leonhiem/cs1800_fpga_cpu/hardware/de0nano_cpu_card/docs/front-panel-notes.md

Front panel notes

Standard 19 inch rack based, covering 2 slots

dimensions: width=40mm  height=128mm
