leonhiem/cs1800_fpga_cpu/hardware/de0nano_cpu_card/bom_smd_assembly.csv

LCSC Part# | MFR.Part# | Designator | Comment | Footprint | Qty | DNP
C14858 | CL10C101JB8NNNC | C1 | 100pF | Capacitor_SMD:C_0603_1608Metric | 1
C2991729 | 0603B104J250NT | C2,C3,C4,C5,C6,C7,C8,C9,C10,C11,C12,C13,C16,C17,C18,C19,C20,C21,C22,C23,C24 | 100nF | Capacitor_SMD:C_0603_1608Metric | 21
C49066 | CL32A107MQVNNNE | C14 | 100uF_LowESR | Capacitor_SMD:C_1210_3225Metric | 1
C39232 | CL32B106KAJNNNE | C15 | 10uF_LowESR | Capacitor_SMD:C_1210_3225Metric | 1
C169541 | 1N5817W | D1 | 1N5817 | Diode_SMD:D_SMA | 1
C5139509 | ABD03K1002FT | R1,R2,R3,R4,R5,R6,R7,R8,R9,R10,R11,R12,R13,R14,R15,R16,R17,R18,R19,R20,R21,R22,R23,R24 | 10k | Resistor_SMD:R_0603_1608Metric | 24
C5139509 | ABD03K1002FT | R_SW1,R_SW2,R_SW3,R_SW4,R_SW5,R_SW6 | 10k | Resistor_SMD:R_0603_1608Metric | 6
C53224189 | 1RC0603F1009 | R28,R29,R30,R31 | 10 | Resistor_SMD:R_0603_1608Metric | 4
C427298 | ERJP03F2200V | R_D1,R_D2,R_D3,R_D4 | 220 | Resistor_SMD:R_0603_1608Metric | 4
C27643 | SN74LVC8T245PWR | U1,U2,U3,U4,U5,U6,U8,U9 | SN74LVC8T245 | Package_SO:TSSOP-24_4.4x7.8mm_P0.65mm | 8
C193666 | MAX3232EIDR | U7 | MAX3232EIDR | Package_SO:SOIC-16_3.9x9.9mm_P1.27mm | 1
