leonhiem/cs1800_fpga_cpu/hardware/de0nano_cpu_card/bom.csv

Designator | Comment | Footprint | Qty | DNP
A1 | RaspberryPi_Pico_W | cs1800:RaspberryPi_Pico_W_SocketHeaders_2x1x20_P2.54mm | 1
C1 | 100pF | Capacitor_SMD:C_0603_1608Metric | 1
C2,C3,C4,C5,C6,C7,C8,C9,C10,C11,C12,C13,C21,C22,C23,C24 | 100nF | Capacitor_SMD:C_0603_1608Metric | 16
C14 | 100uF_LowESR | Capacitor_SMD:C_1210_3225Metric | 1
C15 | 10uF_LowESR | Capacitor_SMD:C_1210_3225Metric | 1
C16,C17,C18,C19,C20 | 0.1uF | Capacitor_SMD:C_0603_1608Metric | 5
D1 | 1N5817 | Diode_SMD:D_SMA | 1
D2 | LED_Green | LED_THT:LED_D3.0mm | 1
D3 | LED_Yellow | LED_THT:LED_D3.0mm | 1
D4,D5 | LED_Red | LED_THT:LED_D3.0mm | 2
J1 | DIN41617_31P | cs1800:DIN41617_31P_Male_Angled | 1
J2 | EXP_HEADER_2x11 | Connector_PinHeader_2.54mm:PinHeader_2x11_P2.54mm_Vertical | 1
J3 | GPIO_0_JP1 | Connector_IDC:IDC-Header_2x20_P2.54mm_Vertical | 1
J4 | GPIO_1_JP2 | Connector_IDC:IDC-Header_2x20_P2.54mm_Vertical | 1
J5 | DB9_RS232 | Connector_Dsub:DSUB-9_Pins_Horizontal_P2.77x2.54mm_EdgePinOffset9.40mm | 1
P1 | DE0Nano_5V_feed | Connector_PinHeader_2.54mm:PinHeader_1x02_P2.54mm_Vertical | 1
R1,R2,R3,R4,R5,R6,R7,R8,R9,R10,R11,R12,R13,R14,R15,R16,R17,R18,R19,R20,R21,R22,R23,R24,R_SW1,R_SW2,R_SW3,R_SW4,R_SW5,R_SW6 | 10k | Resistor_SMD:R_0603_1608Metric | 30
R28,R29,R30,R31 | 10 | Resistor_SMD:R_0603_1608Metric | 4
R_D1,R_D2,R_D3,R_D4 | 220 | Resistor_SMD:R_0603_1608Metric | 4
SW1 | Rocker_run/halt | Connector_PinHeader_2.54mm:PinHeader_1x02_P2.54mm_Vertical | 1
SW2 | Rocker_dog_off | Connector_PinHeader_2.54mm:PinHeader_1x02_P2.54mm_Vertical | 1
SW3 | Rocker_LC_off | Connector_PinHeader_2.54mm:PinHeader_1x02_P2.54mm_Vertical | 1
SW4 | Button_step | Connector_PinHeader_2.54mm:PinHeader_1x02_P2.54mm_Vertical | 1
SW5 | Button_reset | Connector_PinHeader_2.54mm:PinHeader_1x02_P2.54mm_Vertical | 1
SW6 | Button_qef4 | Connector_PinHeader_2.54mm:PinHeader_1x02_P2.54mm_Vertical | 1
U1,U2,U3,U4,U5,U6,U8,U9 | SN74LVC8T245 | Package_SO:TSSOP-24_4.4x7.8mm_P0.65mm | 8
U7 | MAX3232EIDR | Package_SO:SOIC-16_3.9x9.9mm_P1.27mm | 1
