leonhiem/cs1800_fpga_cpu/hardware/de0nano_cpu_card/de0nano_cpu_card.kicad_pcb

## KiCad design hardware/de0nano_cpu_card/de0nano_cpu_card.kicad_pcb (2026-10-16)

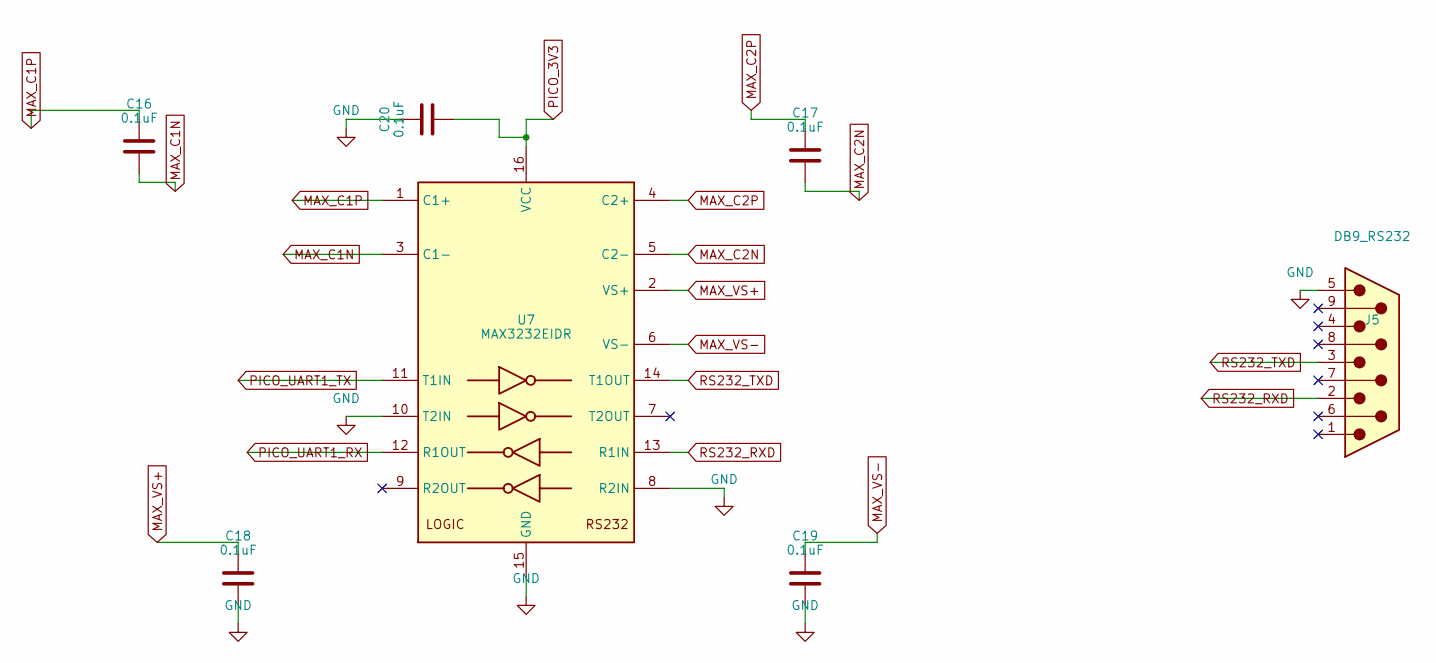
[picture p1: schematic rs232.kicad_sch, RS232 Transceiver (MAX3232) + DB9]

Parts:
C16, C17, C18, C19, C20: 0.1uF; C_0603_1608Metric
J5: DB9_RS232; DSUB-9_Pins_Horizontal_P2.77x2.54mm_EdgePinOffset9.40mm
U7: MAX3232EIDR; SOIC-16_3.9x9.9mm_P1.27mm

Connections:
GND: C18.2, C19.2, C20.1, J5.5, U7.8 (R2IN), U7.10 (T2IN), U7.15 (GND); also elsewhere on the board
MAX_C1N: C16.2, U7.3 (C1-)
MAX_C1P: C16.1, U7.1 (C1+)
MAX_C2N: C17.2, U7.5 (C2-)
MAX_C2P: C17.1, U7.4 (C2+)
MAX_VS+: C18.1, U7.2 (VS+)
MAX_VS-: C19.1, U7.6 (VS-)
PICO_3V3: C20.2, U7.16 (VCC); also elsewhere on the board
PICO_UART1_RX: U7.12 (R1OUT); also elsewhere on the board
PICO_UART1_TX: U7.11 (T1IN); also elsewhere on the board
RS232_RXD: J5.2, U7.13 (R1IN)
RS232_TXD: J5.3, U7.14 (T1OUT)

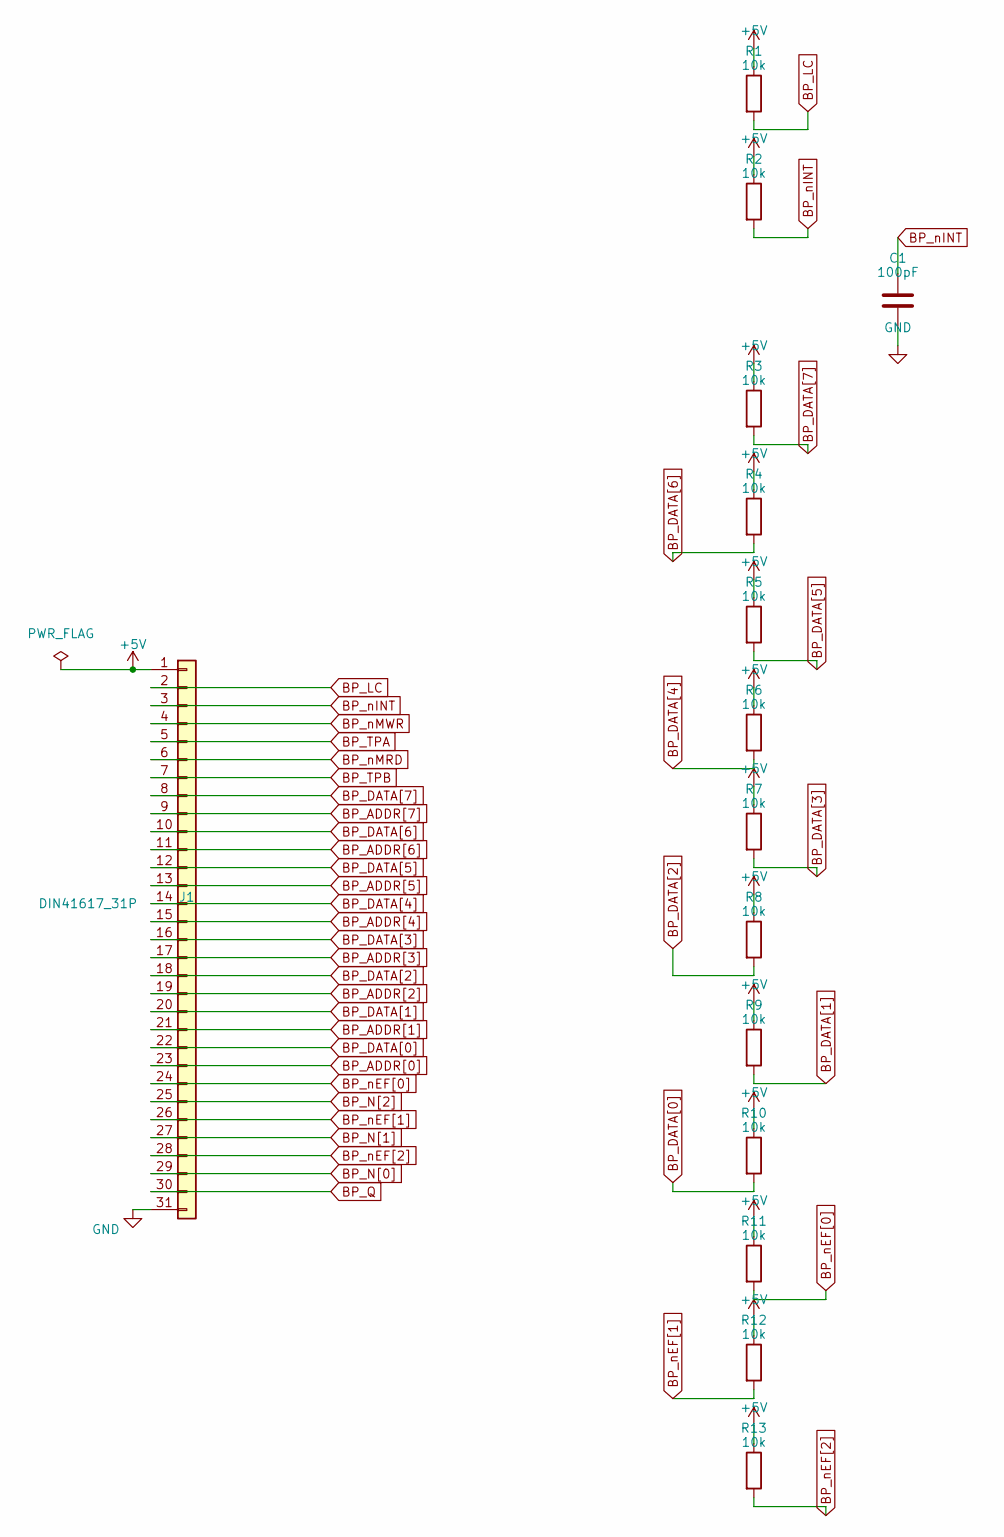
[picture p2: schematic backplane_connector.kicad_sch, Backplane Connector (DIN41617, 31p male)]

Parts:
C1: 100pF; C_0603_1608Metric
J1: DIN41617_31P; DIN41617_31P_Male_Angled
R1, R2, R3, R4, R5, R6, R7, R8, R9, R10, R11, R12, R13: 10k; R_0603_1608Metric

Connections:
+5V: J1.1, R1.1, R2.1, R3.1, R4.1, R5.1, R6.1, R7.1, R8.1, R9.1, R10.1, R11.1, R12.1, R13.1; also elsewhere on the board
BP_ADDR[0]: J1.23; also elsewhere on the board
BP_ADDR[1]: J1.21; also elsewhere on the board
BP_ADDR[2]: J1.19; also elsewhere on the board
BP_ADDR[3]: J1.17; also elsewhere on the board
BP_ADDR[4]: J1.15; also elsewhere on the board
BP_ADDR[5]: J1.13; also elsewhere on the board
BP_ADDR[6]: J1.11; also elsewhere on the board
BP_ADDR[7]: J1.9; also elsewhere on the board
BP_DATA[0]: J1.22, R10.2; also elsewhere on the board
BP_DATA[1]: J1.20, R9.2; also elsewhere on the board
BP_DATA[2]: J1.18, R8.2; also elsewhere on the board
BP_DATA[3]: J1.16, R7.2; also elsewhere on the board
BP_DATA[4]: J1.14, R6.2; also elsewhere on the board
BP_DATA[5]: J1.12, R5.2; also elsewhere on the board
BP_DATA[6]: J1.10, R4.2; also elsewhere on the board
BP_DATA[7]: J1.8, R3.2; also elsewhere on the board
BP_LC: J1.2, R1.2; also elsewhere on the board
BP_N[0]: J1.29; also elsewhere on the board
BP_N[1]: J1.27; also elsewhere on the board
BP_N[2]: J1.25; also elsewhere on the board
BP_Q: J1.30; also elsewhere on the board
BP_TPA: J1.5; also elsewhere on the board
BP_TPB: J1.7; also elsewhere on the board
BP_nEF[0]: J1.24, R11.2; also elsewhere on the board
BP_nEF[1]: J1.26, R12.2; also elsewhere on the board
BP_nEF[2]: J1.28, R13.2; also elsewhere on the board
BP_nINT: C1.1, J1.3, R2.2; also elsewhere on the board
BP_nMRD: J1.6; also elsewhere on the board
BP_nMWR: J1.4; also elsewhere on the board
GND: C1.2, J1.31; also elsewhere on the board

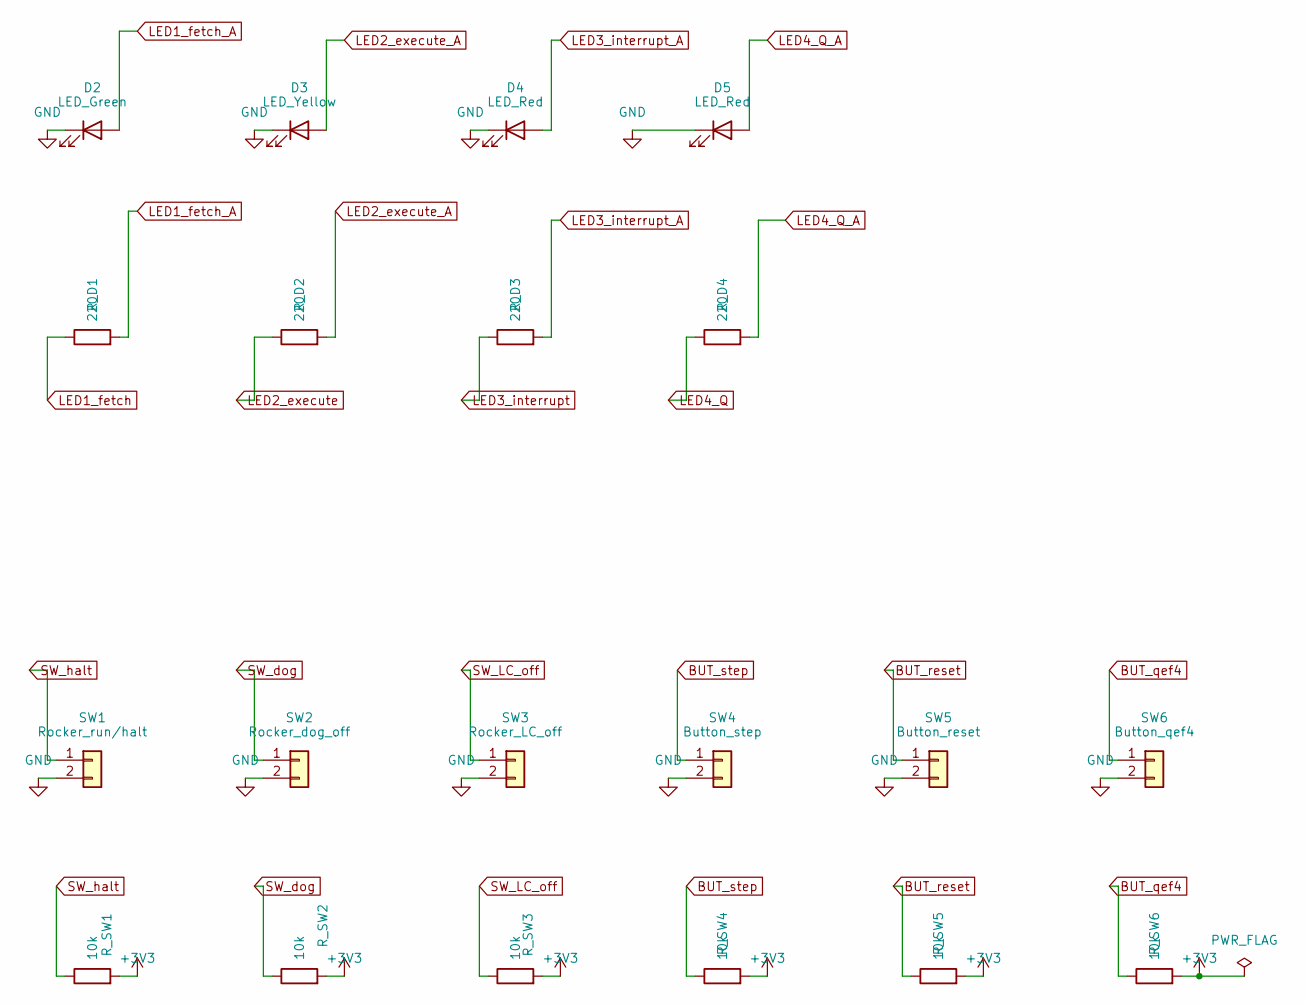
[picture p3: schematic frontpanel_io.kicad_sch, Front Panel I/O]

Parts:
D2: LED_Green; LED_D3.0mm
D3: LED_Yellow; LED_D3.0mm
D4, D5: LED_Red; LED_D3.0mm
R_D1, R_D2, R_D3, R_D4: 220; R_0603_1608Metric
R_SW1, R_SW2, R_SW3, R_SW4, R_SW5, R_SW6: 10k; R_0603_1608Metric
SW1: Rocker_run/halt; PinHeader_1x02_P2.54mm_Vertical
SW2: Rocker_dog_off; PinHeader_1x02_P2.54mm_Vertical
SW3: Rocker_LC_off; PinHeader_1x02_P2.54mm_Vertical
SW4: Button_step; PinHeader_1x02_P2.54mm_Vertical
SW5: Button_reset; PinHeader_1x02_P2.54mm_Vertical
SW6: Button_qef4; PinHeader_1x02_P2.54mm_Vertical

Connections:
+3V3: R_SW1.2, R_SW2.2, R_SW3.2, R_SW4.2, R_SW5.2, R_SW6.2; also elsewhere on the board
BUT_qef4: R_SW6.1, SW6.1; also elsewhere on the board
BUT_reset: R_SW5.1, SW5.1; also elsewhere on the board
BUT_step: R_SW4.1, SW4.1; also elsewhere on the board
GND: D2.1 (K), D3.1 (K), D4.1 (K), D5.1 (K), SW1.2, SW2.2, SW3.2, SW4.2, SW5.2, SW6.2; also elsewhere on the board
LED1_fetch: R_D1.1; also elsewhere on the board
LED1_fetch_A: D2.2 (A), R_D1.2
LED2_execute: R_D2.1; also elsewhere on the board
LED2_execute_A: D3.2 (A), R_D2.2
LED3_interrupt: R_D3.1; also elsewhere on the board
LED3_interrupt_A: D4.2 (A), R_D3.2
LED4_Q: R_D4.1; also elsewhere on the board
LED4_Q_A: D5.2 (A), R_D4.2
SW_LC_off: R_SW3.1, SW3.1; also elsewhere on the board
SW_dog: R_SW2.1, SW2.1; also elsewhere on the board
SW_halt: R_SW1.1, SW1.1; also elsewhere on the board

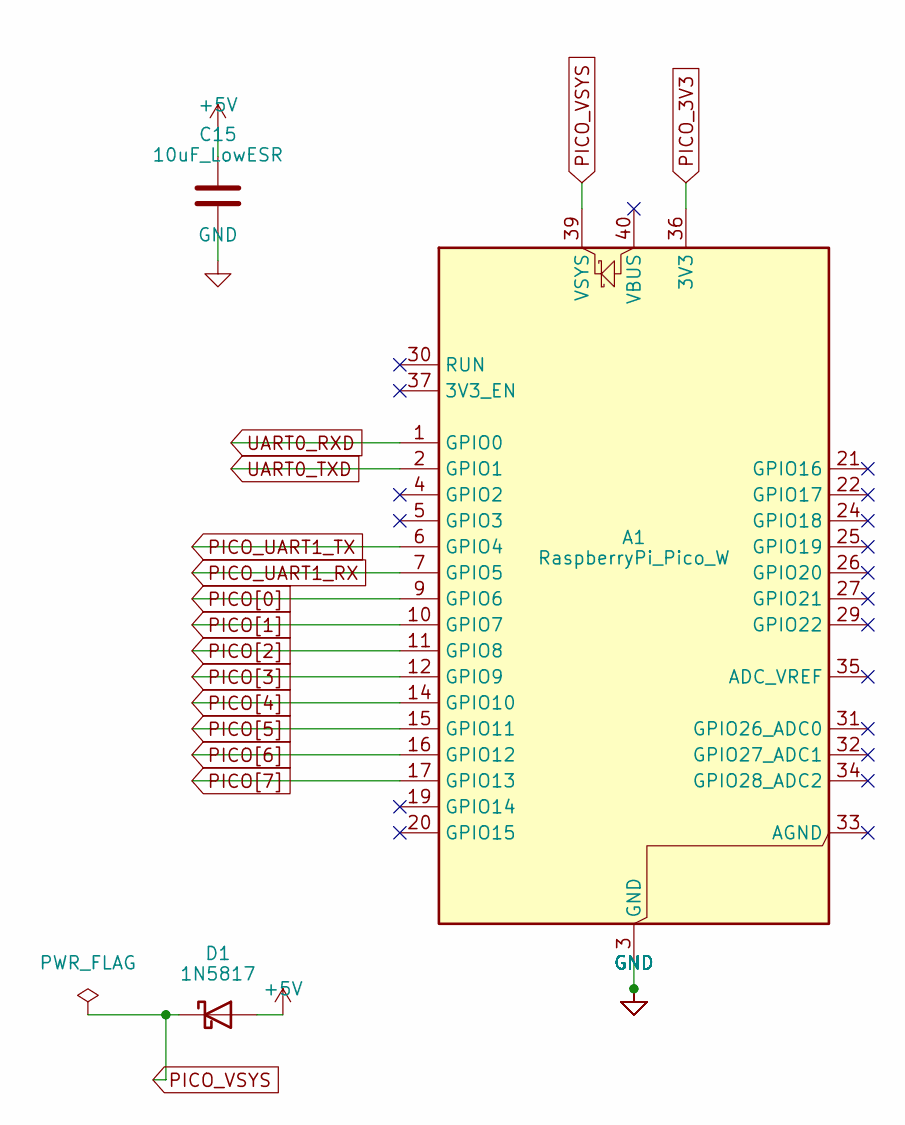
[picture p4: schematic pico_w_bridge.kicad_sch, UART Bridge (Raspberry Pi Pico-W)]

Parts:
A1: RaspberryPi_Pico_W; RaspberryPi_Pico_W_SocketHeaders_2x1x20_P2.54mm
C15: 10uF_LowESR; C_1210_3225Metric
D1: 1N5817; D_SMA

Connections:
+5V: C15.1, D1.2 (A); also elsewhere on the board
GND: A1.3 (GND), A1.8 (GND), A1.13 (GND), A1.18 (GND), A1.23 (GND), A1.28 (GND), A1.38 (GND), C15.2; also elsewhere on the board
PICO[0]: A1.9 (GPIO6); also elsewhere on the board
PICO[1]: A1.10 (GPIO7); also elsewhere on the board
PICO[2]: A1.11 (GPIO8); also elsewhere on the board
PICO[3]: A1.12 (GPIO9); also elsewhere on the board
PICO[4]: A1.14 (GPIO10); also elsewhere on the board
PICO[5]: A1.15 (GPIO11); also elsewhere on the board
PICO[6]: A1.16 (GPIO12); also elsewhere on the board
PICO[7]: A1.17 (GPIO13); also elsewhere on the board
PICO_3V3: A1.36 (3V3); also elsewhere on the board
PICO_UART1_RX: A1.7 (GPIO5); also elsewhere on the board
PICO_UART1_TX: A1.6 (GPIO4); also elsewhere on the board
PICO_VSYS: A1.39 (VSYS), D1.1 (K)
UART0_RXD: A1.1 (GPIO0); also elsewhere on the board
UART0_TXD: A1.2 (GPIO1); also elsewhere on the board

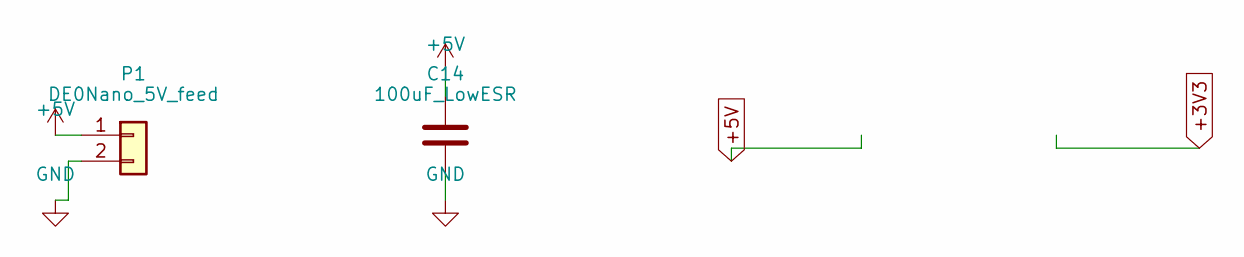
[picture p5: schematic power.kicad_sch, Power (5V in, DE0-Nano feed, rails)]

Parts:
C14: 100uF_LowESR; C_1210_3225Metric
P1: DE0Nano_5V_feed; PinHeader_1x02_P2.54mm_Vertical

Connections:
+5V: C14.1, P1.1; also elsewhere on the board
GND: C14.2, P1.2; also elsewhere on the board

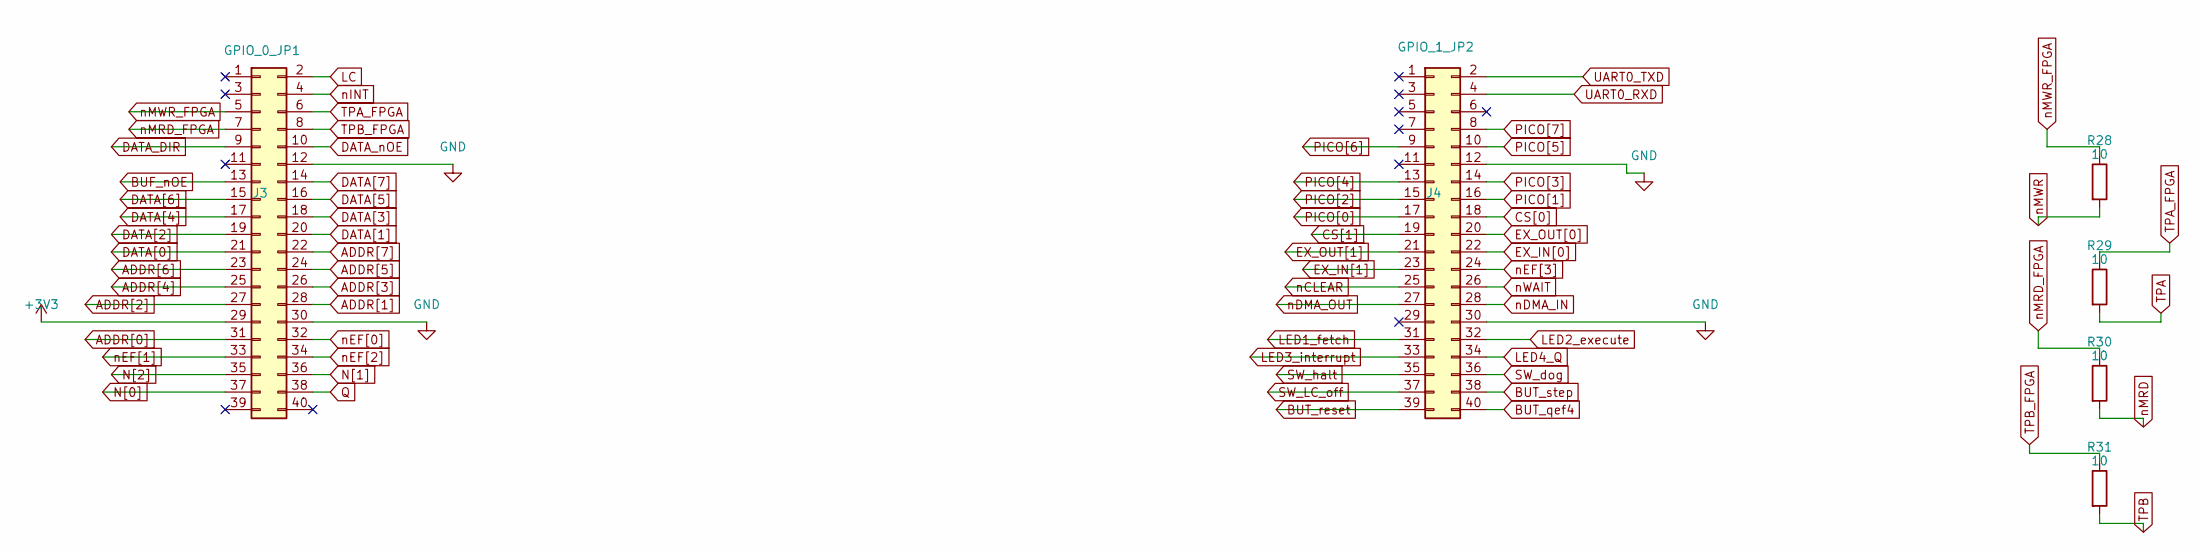
[picture p6: schematic fpga_header.kicad_sch, DE0-Nano GPIO Header / Ribbon I-F]

Parts:
J3: GPIO_0_JP1; IDC-Header_2x20_P2.54mm_Vertical
J4: GPIO_1_JP2; IDC-Header_2x20_P2.54mm_Vertical
R28, R29, R30, R31: 10; R_0603_1608Metric

Connections:
+3V3: J3.29; also elsewhere on the board
ADDR[0]: J3.31; also elsewhere on the board
ADDR[1]: J3.28; also elsewhere on the board
ADDR[2]: J3.27; also elsewhere on the board
ADDR[3]: J3.26; also elsewhere on the board
ADDR[4]: J3.25; also elsewhere on the board
ADDR[5]: J3.24; also elsewhere on the board
ADDR[6]: J3.23; also elsewhere on the board
ADDR[7]: J3.22; also elsewhere on the board
BUF_nOE: J3.13; also elsewhere on the board
BUT_qef4: J4.40; also elsewhere on the board
BUT_reset: J4.39; also elsewhere on the board
BUT_step: J4.38; also elsewhere on the board
CS[0]: J4.18; also elsewhere on the board
CS[1]: J4.19; also elsewhere on the board
DATA[0]: J3.21; also elsewhere on the board
DATA[1]: J3.20; also elsewhere on the board
DATA[2]: J3.19; also elsewhere on the board
DATA[3]: J3.18; also elsewhere on the board
DATA[4]: J3.17; also elsewhere on the board
DATA[5]: J3.16; also elsewhere on the board
DATA[6]: J3.15; also elsewhere on the board
DATA[7]: J3.14; also elsewhere on the board
DATA_DIR: J3.9; also elsewhere on the board
DATA_nOE: J3.10; also elsewhere on the board
EX_IN[0]: J4.22; also elsewhere on the board
EX_IN[1]: J4.23; also elsewhere on the board
EX_OUT[0]: J4.20; also elsewhere on the board
EX_OUT[1]: J4.21; also elsewhere on the board
GND: J3.12, J3.30, J4.12, J4.30; also elsewhere on the board
LC: J3.2; also elsewhere on the board
LED1_fetch: J4.31; also elsewhere on the board
LED2_execute: J4.32; also elsewhere on the board
LED3_interrupt: J4.33; also elsewhere on the board
LED4_Q: J4.34; also elsewhere on the board
N[0]: J3.37; also elsewhere on the board
N[1]: J3.36; also elsewhere on the board
N[2]: J3.35; also elsewhere on the board
PICO[0]: J4.17; also elsewhere on the board
PICO[1]: J4.16; also elsewhere on the board
PICO[2]: J4.15; also elsewhere on the board
PICO[3]: J4.14; also elsewhere on the board
PICO[4]: J4.13; also elsewhere on the board
PICO[5]: J4.10; also elsewhere on the board
PICO[6]: J4.9; also elsewhere on the board
PICO[7]: J4.8; also elsewhere on the board
Q: J3.38; also elsewhere on the board
SW_LC_off: J4.37; also elsewhere on the board
SW_dog: J4.36; also elsewhere on the board
SW_halt: J4.35; also elsewhere on the board
TPA: R29.2; also elsewhere on the board
TPA_FPGA: J3.6, R29.1
TPB: R31.2; also elsewhere on the board
TPB_FPGA: J3.8, R31.1
UART0_RXD: J4.4; also elsewhere on the board
UART0_TXD: J4.2; also elsewhere on the board
nCLEAR: J4.25; also elsewhere on the board
nDMA_IN: J4.28; also elsewhere on the board
nDMA_OUT: J4.27; also elsewhere on the board
nEF[0]: J3.32; also elsewhere on the board
nEF[1]: J3.33; also elsewhere on the board
nEF[2]: J3.34; also elsewhere on the board
nEF[3]: J4.24; also elsewhere on the board
nINT: J3.4; also elsewhere on the board
nMRD: R30.2; also elsewhere on the board
nMRD_FPGA: J3.7, R30.1
nMWR: R28.2; also elsewhere on the board
nMWR_FPGA: J3.5, R28.1
nWAIT: J4.26; also elsewhere on the board

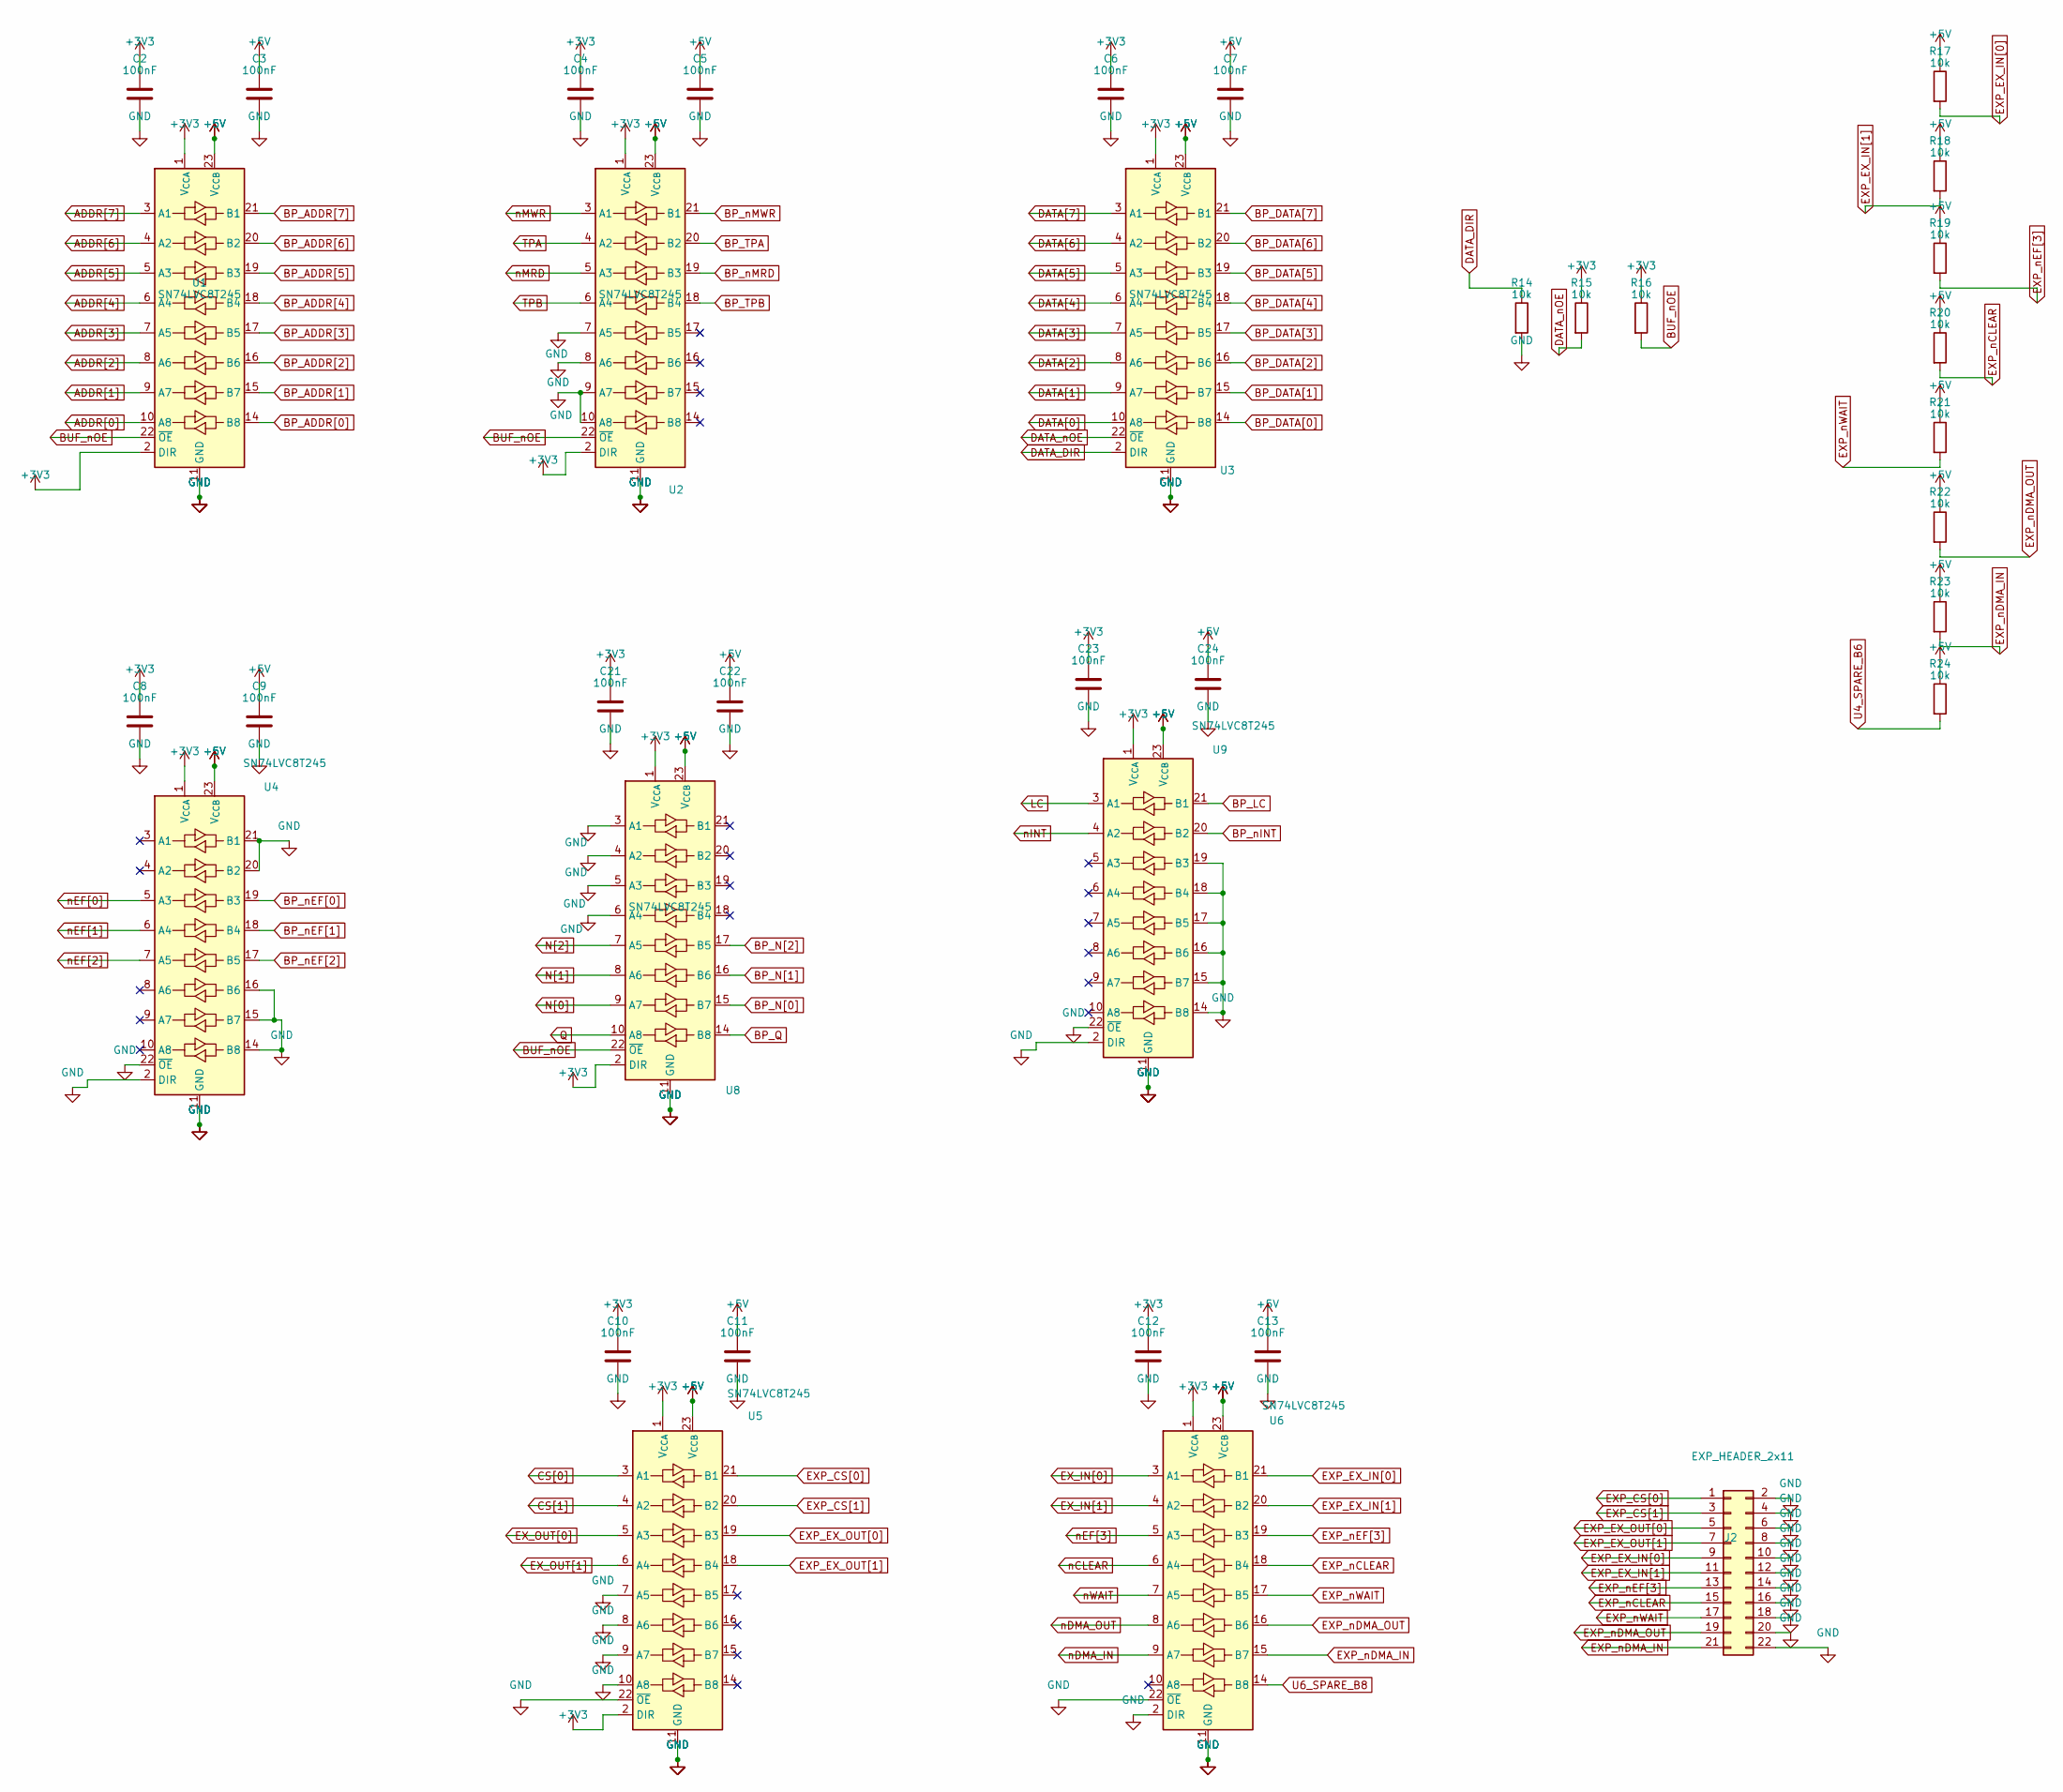
[picture p7: schematic level_shifters.kicad_sch, Level Shifters (6x SN74LVC8T245)]

Parts:
C2, C3, C4, C5, C6, C7, C8, C9, C10, C11, C12, C13, C21, C22, C23, C24: 100nF; C_0603_1608Metric
J2: EXP_HEADER_2x11; PinHeader_2x11_P2.54mm_Vertical
R14, R15, R16, R17, R18, R19, R20, R21, R22, R23, R24: 10k; R_0603_1608Metric
U1, U2, U3, U4, U5, U6, U8, U9: SN74LVC8T245; TSSOP-24_4.4x7.8mm_P0.65mm

Connections:
+3V3: C2.1, C4.1, C6.1, C8.1, C10.1, C12.1, C21.1, C23.1, R15.1, R16.1, U1.1 (V_{CCA}), U1.2 (DIR), U2.1 (V_{CCA}), U2.2 (DIR), U3.1 (V_{CCA}), U4.1 (V_{CCA}), U5.1 (V_{CCA}), U5.2 (DIR), U6.1 (V_{CCA}), U8.1 (V_{CCA}), U8.2 (DIR), U9.1 (V_{CCA}); also elsewhere on the board
+5V: C3.1, C5.1, C7.1, C9.1, C11.1, C13.1, C22.1, C24.1, R17.1, R18.1, R19.1, R20.1, R21.1, R22.1, R23.1, R24.1, U1.23 (V_{CCB}), U1.24 (V_{CCB}), U2.23 (V_{CCB}), U2.24 (V_{CCB}), U3.23 (V_{CCB}), U3.24 (V_{CCB}), U4.23 (V_{CCB}), U4.24 (V_{CCB}), U5.23 (V_{CCB}), U5.24 (V_{CCB}), U6.23 (V_{CCB}), U6.24 (V_{CCB}), U8.23 (V_{CCB}), U8.24 (V_{CCB}), U9.23 (V_{CCB}), U9.24 (V_{CCB}); also elsewhere on the board
ADDR[0]: U1.10 (A8); also elsewhere on the board
ADDR[1]: U1.9 (A7); also elsewhere on the board
ADDR[2]: U1.8 (A6); also elsewhere on the board
ADDR[3]: U1.7 (A5); also elsewhere on the board
ADDR[4]: U1.6 (A4); also elsewhere on the board
ADDR[5]: U1.5 (A3); also elsewhere on the board
ADDR[6]: U1.4 (A2); also elsewhere on the board
ADDR[7]: U1.3 (A1); also elsewhere on the board
BP_ADDR[0]: U1.14 (B8); also elsewhere on the board
BP_ADDR[1]: U1.15 (B7); also elsewhere on the board
BP_ADDR[2]: U1.16 (B6); also elsewhere on the board
BP_ADDR[3]: U1.17 (B5); also elsewhere on the board
BP_ADDR[4]: U1.18 (B4); also elsewhere on the board
BP_ADDR[5]: U1.19 (B3); also elsewhere on the board
BP_ADDR[6]: U1.20 (B2); also elsewhere on the board
BP_ADDR[7]: U1.21 (B1); also elsewhere on the board
BP_DATA[0]: U3.14 (B8); also elsewhere on the board
BP_DATA[1]: U3.15 (B7); also elsewhere on the board
BP_DATA[2]: U3.16 (B6); also elsewhere on the board
BP_DATA[3]: U3.17 (B5); also elsewhere on the board
BP_DATA[4]: U3.18 (B4); also elsewhere on the board
BP_DATA[5]: U3.19 (B3); also elsewhere on the board
BP_DATA[6]: U3.20 (B2); also elsewhere on the board
BP_DATA[7]: U3.21 (B1); also elsewhere on the board
BP_LC: U9.21 (B1); also elsewhere on the board
BP_N[0]: U8.15 (B7); also elsewhere on the board
BP_N[1]: U8.16 (B6); also elsewhere on the board
BP_N[2]: U8.17 (B5); also elsewhere on the board
BP_Q: U8.14 (B8); also elsewhere on the board
BP_TPA: U2.20 (B2); also elsewhere on the board
BP_TPB: U2.18 (B4); also elsewhere on the board
BP_nEF[0]: U4.19 (B3); also elsewhere on the board
BP_nEF[1]: U4.18 (B4); also elsewhere on the board
BP_nEF[2]: U4.17 (B5); also elsewhere on the board
BP_nINT: U9.20 (B2); also elsewhere on the board
BP_nMRD: U2.19 (B3); also elsewhere on the board
BP_nMWR: U2.21 (B1); also elsewhere on the board
BUF_nOE: R16.2, U1.22 (~OE), U2.22 (~OE), U8.22 (~OE); also elsewhere on the board
CS[0]: U5.3 (A1); also elsewhere on the board
CS[1]: U5.4 (A2); also elsewhere on the board
DATA[0]: U3.10 (A8); also elsewhere on the board
DATA[1]: U3.9 (A7); also elsewhere on the board
DATA[2]: U3.8 (A6); also elsewhere on the board
DATA[3]: U3.7 (A5); also elsewhere on the board
DATA[4]: U3.6 (A4); also elsewhere on the board
DATA[5]: U3.5 (A3); also elsewhere on the board
DATA[6]: U3.4 (A2); also elsewhere on the board
DATA[7]: U3.3 (A1); also elsewhere on the board
DATA_DIR: R14.1, U3.2 (DIR); also elsewhere on the board
DATA_nOE: R15.2, U3.22 (~OE); also elsewhere on the board
EXP_CS[0]: J2.1, U5.21 (B1)
EXP_CS[1]: J2.3, U5.20 (B2)
EXP_EX_IN[0]: J2.9, R17.2, U6.21 (B1)
EXP_EX_IN[1]: J2.11, R18.2, U6.20 (B2)
EXP_EX_OUT[0]: J2.5, U5.19 (B3)
EXP_EX_OUT[1]: J2.7, U5.18 (B4)
EXP_nCLEAR: J2.15, R20.2, U6.18 (B4)
EXP_nDMA_IN: J2.21, R23.2, U6.15 (B7)
EXP_nDMA_OUT: J2.19, R22.2, U6.16 (B6)
EXP_nEF[3]: J2.13, R19.2, U6.19 (B3)
EXP_nWAIT: J2.17, R21.2, U6.17 (B5)
EX_IN[0]: U6.3 (A1); also elsewhere on the board
EX_IN[1]: U6.4 (A2); also elsewhere on the board
EX_OUT[0]: U5.5 (A3); also elsewhere on the board
EX_OUT[1]: U5.6 (A4); also elsewhere on the board
GND: C2.2, C3.2, C4.2, C5.2, C6.2, C7.2, C8.2, C9.2, C10.2, C11.2, C12.2, C13.2, C21.2, C22.2, C23.2, C24.2, J2.2, J2.4, J2.6, J2.8, J2.10, J2.12, J2.14, J2.16, J2.18, J2.20, J2.22, R14.2, U1.11 (GND), U1.12 (GND), U1.13 (GND), U2.7 (A5), U2.8 (A6), U2.9 (A7), U2.10 (A8), U2.11 (GND), U2.12 (GND), U2.13 (GND), U3.11 (GND), U3.12 (GND), U3.13 (GND), U4.2 (DIR), U4.11 (GND), U4.12 (GND), U4.13 (GND), U4.14 (B8), U4.15 (B7), U4.16 (B6), U4.20 (B2), U4.21 (B1), U4.22 (~OE), U5.7 (A5), U5.8 (A6), U5.9 (A7), U5.10 (A8), U5.11 (GND), U5.12 (GND), U5.13 (GND), U5.22 (~OE), U6.2 (DIR), U6.11 (GND), U6.12 (GND), U6.13 (GND), U6.22 (~OE), U8.3 (A1), U8.4 (A2), U8.5 (A3), U8.6 (A4), U8.11 (GND), U8.12 (GND), U8.13 (GND), U9.2 (DIR), U9.11 (GND), U9.12 (GND), U9.13 (GND), U9.14 (B8), U9.15 (B7), U9.16 (B6), U9.17 (B5), U9.18 (B4), U9.19 (B3), U9.22 (~OE); also elsewhere on the board
LC: U9.3 (A1); also elsewhere on the board
N[0]: U8.9 (A7); also elsewhere on the board
N[1]: U8.8 (A6); also elsewhere on the board
N[2]: U8.7 (A5); also elsewhere on the board
Q: U8.10 (A8); also elsewhere on the board
TPA: U2.4 (A2); also elsewhere on the board
TPB: U2.6 (A4); also elsewhere on the board
nCLEAR: U6.6 (A4); also elsewhere on the board
nDMA_IN: U6.9 (A7); also elsewhere on the board
nDMA_OUT: U6.8 (A6); also elsewhere on the board
nEF[0]: U4.5 (A3); also elsewhere on the board
nEF[1]: U4.6 (A4); also elsewhere on the board
nEF[2]: U4.7 (A5); also elsewhere on the board
nEF[3]: U6.5 (A3); also elsewhere on the board
nINT: U9.4 (A2); also elsewhere on the board
nMRD: U2.5 (A3); also elsewhere on the board
nMWR: U2.3 (A1); also elsewhere on the board
nWAIT: U6.7 (A5); also elsewhere on the board

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
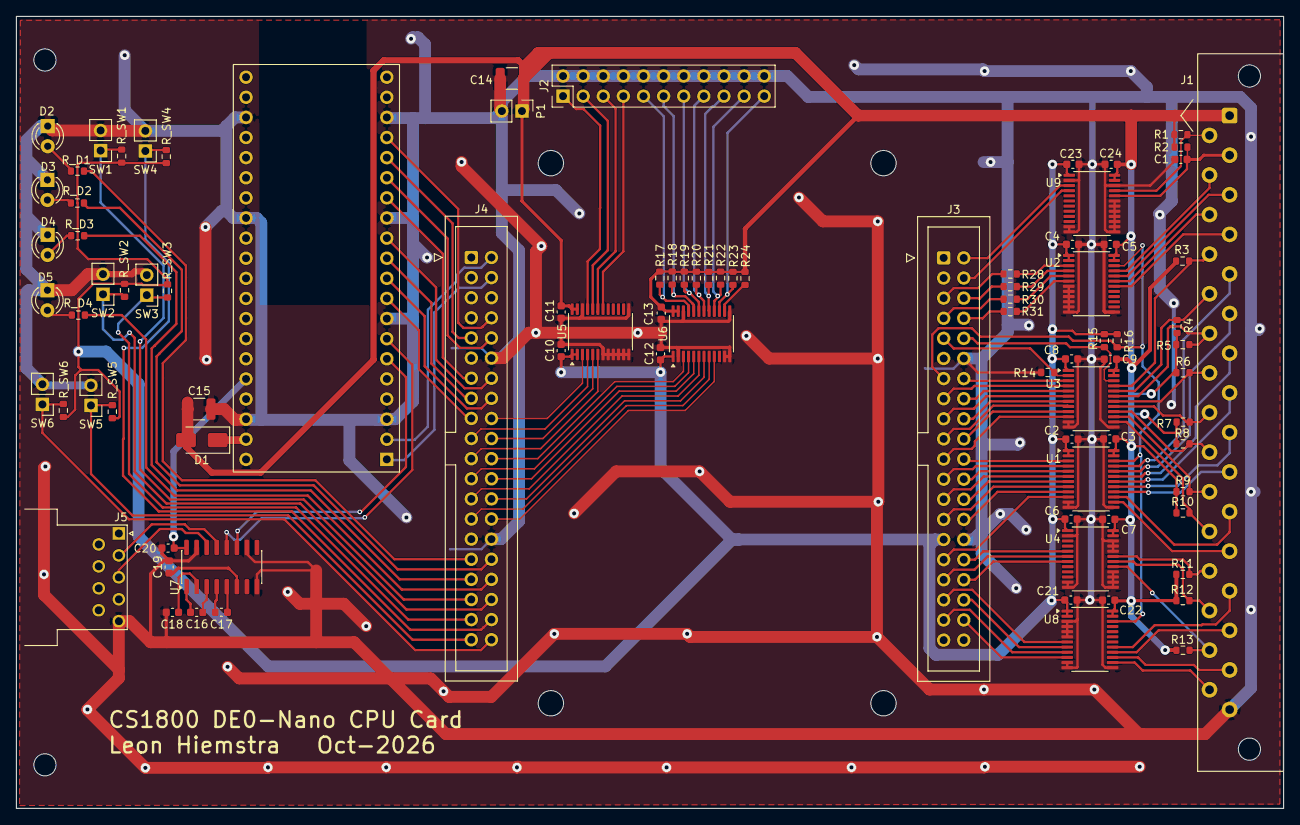
[picture p8: board de0nano_cpu_card.kicad_pcb from above]

Board: 2 copper layers, 160.0 x 100.0 mm, 92 parts (0 on the bottom side), 127 nets.

Other parts of the board:
DE0NANO: DE0-Nano (reference); DE0Nano_Reference_Outline
MH1, MH2: f; MountingHole_2.8mm
