leonhiem/cs1800_fpga_cpu/(commit log)

2026-10-05 Initial KiCad project skeleton for CS1800 DE0-Nano CPU card
    Hierarchical schematic (7 placeholder sheets), placeholder PCB outline,
    project-local library setup, design notes, and backplane pinout captured
    from the real DIN41617 connector (31p: +5V, GND, and 28 CDP1802 bus
    signals that all need level-shifting except pin 1/31).
    [backplane_connector.kicad_sch, de0nano_cpu_card.kicad_pcb, de0nano_cpu_card.kicad_sch, fpga_header.kicad_sch, frontpanel_io.kicad_sch, level_shifters.kicad_sch, power.kicad_sch, rs232.kicad_sch]
2026-10-05 Sync docs/schematic skeleton with FT2232H -> Raspberry Pi Pico-W decision
    Pico-W replaces the FT2232H dual-UART bridge (cheaper, fast enough for
    2 simple UARTs, adds WiFi/telnet and spare GPIOs for free). Renamed the
    placeholder schematic sheet accordingly and updated design_notes.md to
    reflect the now-resolved backplane pinout, Eurocard floorplan, and
    front-panel wiring, plus the new open items the Pico-W swap introduces
    (antenna keepout, USB/backplane back-feed protection).
    [de0nano_cpu_card.kicad_sch, pico_w_bridge.kicad_sch]
2026-10-09 FPGA pin assignment done: rewrite design_notes.md as full synthesis
    cs1800.qsf pins down GPIO_0 (backplane, via level shifters) and GPIO_1
    (Pico-W link, future-expansion header, front panel LEDs/switches).
    Key corrections/additions over the previous notes:
    - 6x SN74LVC8T245 needed, not 4 (4 for the backplane bus, 2 more for an
    11-signal CDP1802 control/future-expansion header that isn't on the
    backplane).
    - DIN41617 connector physically identified and sourced: Amphenol
    101-A-10119-X, 31-pos male angled, from the Conec datasheet, with full
    mechanical dims for a custom KiCad footprint.
    - DE0-Nano board size confirmed (49 x 75.2mm).
    - OE/DIR default-state strapping worked out for safe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
2026-10-09 Close out remaining open items: mechanical, MAX3232, Pico-W power protection
    - DE0-Nano mounting hole coordinates derived (de0-nano_notes.md):
    4x M3 holes at (3.5,3.5)/(3.5,71.7)/(45.5,3.5)/(45.5,71.7)mm, from
    community CAD data since Terasic doesn't publish an official drawing.
    - Front panel envelope confirmed (front-panel-notes.md): 40mm wide x
    128mm tall, double-slot 19" rack. Exact control hole positions will be
    hand-drilled, not engineered in CAD.
    - RS232 transceiver decided: MAX3232EIDR (SOIC-16).
    - Pico-W USB back-feed protection decided: 1N5817 Schottky diode, board
    +5V -> VSYS (pin 39).
    design_notes.md's open-questions list is now empty -- architecture and
    sourcing are fu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
2026-10-09 Wire up all 7 schematic sheets with real nets
    All architecture/sourcing decisions were already resolved; this wires
    them into the actual schematic, generated from docs/cs1800.qsf and the
    other docs/ files via a small purpose-built generator (tools/) rather
    than hand-placing ~400 pins in the GUI:
    - backplane_connector: DIN41617 31p + 13 pull-up resistors per the
    backplane pinout's *1/*2 notes
    - level_shifters: all 6 SN74LVC8T245 (4 backplane + 2 future-expansion),
    DIR/OE strapping per the power-up-safe defaults in backplane_notes.md,
    plus the future-expansion 2x11 header that was previously only
    documented, not placed
    - fpga_header: both DE0-Nano GPIO headers (JP1/JP2), every pin fro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
    [backplane_connector.kicad_sch, fpga_header.kicad_sch, frontpanel_io.kicad_sch, level_shifters.kicad_sch, pico_w_bridge.kicad_sch, power.kicad_sch, rs232.kicad_sch]
2026-10-09 Build the custom DIN41617 31-pin connector footprint
    cs1800:DIN41617_31P_Male_Angled in libraries/footprints/cs1800.pretty/,
    generated by tools/gen_din41617_fp.py from the Conec datasheet's
    dimensioned PCB-hole-pattern drawing: 31 pads at 2.50mm pitch (pin1
    marked, 1.1mm drill), 2x NPTH mounting holes 5mm outboard of pin1/pin31
    on the same axis (2.8mm drill, 85mm apart matching the datasheet). Body/
    silkscreen/courtyard outline is a placeholder (only the 90.6mm overall
    length is datasheet-confirmed) -- flagged for verification against the
    physical part before final fab.
    kicad-cli fp upgrade: parses clean. sch erc on the full hierarchy: 0
    errors, down to 2 cosmetic warnings (the footprint_li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
    [gen_din41617_fp.py]
2026-10-09 Fix stale comment in build_backplane.py
    [build_backplane.py]
2026-10-09 Mount Pico-W on socket headers instead of direct-solder
    Needed so the Pico-W's own micro-USB port has room for a cable once
    elevated above this board -- direct-soldering it would sit the module
    right on the PCB surface with no clearance.
    New footprint cs1800:RaspberryPi_Pico_W_SocketHeaders_2x1x20_P2.54mm
    (tools/gen_pico_socket_fp.py): two 1x20 2.54mm-pitch socket rows,
    17.78mm apart, matching genuine Pico/Pico W header spacing (cross-
    checked against KiCad's own RaspberryPi_Pico_Common_THT footprint).
    Pad numbering 1-20/21-40 matches the Pico's own pin numbers.
    Noted in the BOM that the socket strips should be a tall/stacking-
    height part, not low-profile -- the footprint only fixes pad
    p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
    [pico_w_bridge.kicad_sch]
2026-10-09 Add pull-ups/ties on spare channels and series resistors, per GUI review
    The user reviewed the schematics in the KiCad GUI and manually
    rearranged component layout on several sheets -- so these fixes are
    applied as surgical patches to the current saved files (new
    tools/patch_*.py scripts) rather than via the usual build_*.py
    regeneration, which would have discarded that layout work. See the new
    "don't just re-run build_*.py" section in tools/README.md for the
    workflow this establishes going forward.
    Electrical changes (level_shifters.kicad_sch):
    - 10k pull-up to +5V on all 7 EXP_* future-expansion header input nets
    - U4 (backplane IN chip) spare B-side channels (pins 14/15/16): pulled
    out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
    [backplane_connector.kicad_sch, de0nano_cpu_card.kicad_sch, fpga_header.kicad_sch, frontpanel_io.kicad_sch, level_shifters.kicad_sch, pico_w_bridge.kicad_sch, power.kicad_sch, rs232.kicad_sch]
2026-10-09 Add decoupling caps for all 6 level shifters (12x 100nF)
    Each SN74LVC8T245 needs a 100nF ceramic cap on both supplies (VCCA=3V3,
    VCCB=5V) -- 12 caps total (C1-C12), added via a surgical patch script
    (tools/patch_level_shifters_decoupling.py) to preserve the user's GUI
    layout, same approach as the previous pull-up/series-resistor patches.
    Noted in design_notes.md as a PCB-layout requirement, not just a
    schematic one: each cap needs to sit physically close to its IC's
    VCCA/VCCB pin when placing parts, which the schematic placement alone
    doesn't guarantee.
    sch erc: still 0 errors, same warnings as before. pcb drc: 0 violations.
    [level_shifters.kicad_sch]
2026-10-09 Layout rearrangement (GUI review pass)
    User's manual component layout cleanup in the KiCad GUI across
    backplane_connector, fpga_header, level_shifters, and pico_w_bridge
    sheets. No netlist changes -- verified against the prior commit: all
    33 components in level_shifters.kicad_sch (U1-U6, R1-R3+R10-R20,
    C1-C12, J2) still present, sch erc still 0 errors with the same
    warnings as before, pcb drc still 0 violations.
    [backplane_connector.kicad_sch, fpga_header.kicad_sch, level_shifters.kicad_sch, pico_w_bridge.kicad_sch]
2026-10-09 Fix cross-sheet reference-designator collisions (required for PCB work)
    Each build_*.py numbered its own parts independently (R1, C1, J1, U1,
    etc. each starting fresh per sheet), which kicad-cli sch erc never
    flagged -- ERC resolves connectivity by net name, not reference, so
    duplicate refs across sheets are invisible to it. Only surfaced when
    starting PCB work: `kicad-cli sch export netlist` warned about
    annotation errors, and its (components) section showed 19 reference
    names each silently mapping to 2-4 different real parts (89 components
    total, e.g. "R1" meant three unrelated resistors on three sheets).
    Fixed via tools/patch_reannotate_global.py: 60 references renumbered
    to be globally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
    [backplane_connector.kicad_sch, fpga_header.kicad_sch, frontpanel_io.kicad_sch, level_shifters.kicad_sch, pico_w_bridge.kicad_sch, power.kicad_sch, rs232.kicad_sch]
2026-10-09 PCB: real board outline, DE0-Nano reference, all 86 components placed
    kicad-cli has no "update PCB from schematic" command, so getting the
    schematic's components onto the board required building equivalent
    tooling (tools/pcbgen.py + tools/build_pcb.py), parsing the schematic's
    exported netlist for authoritative net/footprint data and real
    .kicad_mod footprint files (staged in tools/fpstage/) for pad layout.
    - Real 100x160mm Eurocard outline (was a generic placeholder rectangle)
    - New cs1800:DE0Nano_Reference_Outline footprint: mechanical-only (NPTH
    mounting holes at the coordinates from design_notes.md Sec7, no
    copper pads -- the DE0-Nano connects via 2 ribbon cables, not by
    soldering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
    [de0nano_cpu_card.kicad_pcb]
2026-10-09 Fix DIN41617 (J1) pin order and add zigzag pad pattern
    Pin 1 was ending up at the board's bottom-right instead of top-right
    (pin 31 reversed likewise) due to the footprint's local pin-numbering
    direction vs. J1's 90-degree placement rotation. Also, all 31 pads were
    on a single straight line; the datasheet's PCB-hole-pattern drawing
    shows a zigzag: odd pins on one row, even pins offset 2.54mm inward.
    Both caught by visual inspection against the datasheet in the GUI.
    Verified the fix with kicad-cli pcb render (cropped corner renders)
    rather than hand-reasoning about KiCad's rotation-angle sign convention.
    pcb drc: still 0 electrical shorts, 309 unrouted (unchanged), cosmetic
    warnings 73 (down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
    [de0nano_cpu_card.kicad_pcb]
2026-10-09 Fix DIN41617 (J1) mounting hole and body-edge positions
    Real datasheet dimensions from the user's reading of the PCB-hole-pattern
    drawing: each mounting hole is 2.5mm from its nearest end pin (pin1/pin31)
    in the depth direction, the two mounting holes are 85mm apart center to
    center (cross-checks against the datasheet's own D=85 dimension, which
    also confirms the existing along-row hole spacing was already correct),
    and the plastic body's near edge is a further 4.3mm out from the
    mounting hole. Replaces the previous unverified guesses for those values.
    pcb drc: still 0 electrical shorts, 309 unrouted, cosmetic warnings 72
    (down from 73). Noted in design_notes.md that the mounting holes now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
    [de0nano_cpu_card.kicad_pcb]
2026-10-09 Fix DIN41617 body outline: pads/holes were outside it, not inside
    The 4.3mm plastic-edge dimension from the datasheet was applied to the
    near edge of the body rectangle, putting the whole outline beyond the
    mounting holes and pads instead of enclosing them. It's the FAR edge
    (beyond the mounting holes, toward the board edge/mating face); the near
    edge is an unverified small-margin placeholder on the other side.
    Verified with a kicad-cli pcb render crop that pads and both mounting
    holes now land inside the outline. pcb drc: still 0 shorts, 309
    unrouted, 73 cosmetic warnings.
    [de0nano_cpu_card.kicad_pcb]
2026-10-09 Add 2 front-panel mounting holes on the board's left edge
    Plain NPTH, 2.8mm drill, new generic cs1800:MountingHole_2.8mm footprint
    (not tied to any connector/part, reusable for future mechanical-only
    holes). Placed at (3.6, 5.5) and (3.6, 94.5) mm per the user's panel
    measurements: 3.6mm from the left board edge, 5.5mm from top/bottom
    edge, 89mm apart.
    pcb drc: still 0 electrical shorts, 309 unrouted, 73 cosmetic warnings.
    [de0nano_cpu_card.kicad_pcb]
2026-10-09 Fixed mounting holes and backplane connector location
    [de0nano_cpu_card.kicad_pcb]
2026-10-10 placement optimalization process
    [de0nano_cpu_card.kicad_pcb]
2026-10-13 more routing done. also done several pin swapping
2026-10-15 Added GND via-stitching and GND planes
2026-10-15 Restore PWR_FLAGs, document 8-level-shifter GND-tie change
    Schematic (user, GUI): re-added the 3 PWR_FLAG symbols (backplane +5V,
    front-panel GND, Pico-W VSYS) that were deleted by mistake, clearing the
    3 power_pin_not_driven ERC errors from the last round of edits. sch erc:
    0 errors.
    Docs: updated design_notes.md to match the user's own architecture
    change made during final placement/routing -- level shifters increased
    from 6 to 8 (U8/U9 added, both backplane-facing: 6 backplane + 2
    future-expansion chips now), and all spare/unused channels across every
    chip are now hard-tied to GND (no pull-up resistors), since DIR is
    statically strapped on each chip (no bus-contention risk) and the
    datas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
2026-10-16 Add production Gerbers/drill files and upload-ready zip
    Fabrication output for JLCPCB: all 7 Gerber layers (F.Cu, B.Cu,
    F.SilkS, B.SilkS, F.Mask, B.Mask, Edge.Cuts), PTH/NPTH Excellon drill
    files, and de0nano_cpu_card_gerbers.zip bundling all of it flat for
    direct upload to JLCPCB's instant-quote page. Generated via
    kicad-cli pcb export gerbers/drill (the GUI's Fabrication Outputs
    dialog has a layer-selection widget bug in this KiCad 10 AppImage
    build; the CLI equivalent sidesteps it and produces identical output).
2026-10-16 Save plot-dialog settings, drop stray empty report.txt
    kicad_pcb/kicad_pro: harmless pcbplotparams bookkeeping from the last
    GUI save (last-used Gerber output folder, drill-mark display
    preference) -- no board content changed, verified before committing.
    report.txt was an empty (0-byte) leftover from an interrupted report
    attempt, never tracked -- deleted rather than committed.
2026-10-16 Add BOM and SMD assembly CPL for JLCPCB PCBA
    bom.csv: full BOM (89 parts / 27 line items), master reference.
    bom_smd_assembly.csv + cpl_smd.csv: the SMT-only subset to submit for
    JLCPCB assembly -- 72 parts / 11 line items, all top-side (single-sided
    SMT), designator counts verified to match between the two files. Covers
    the 8 level shifters (TSSOP-24) and MAX3232 (SOIC-16) that are
    impractical to hand-solder, plus the 0603/1210 passives and the SMA
    diode. The 16 remaining line items (connectors, pin headers, LEDs,
    Pico-W sockets) are plain THT, left for hand assembly.
    Generated via kicad-cli sch export bom / pcb export pos --smd-only.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
2026-10-16 Fix CPL column headers for JLCPCB's CPL uploader
    kicad-cli pcb export pos has no column-rename option, so it writes its
    own header names (Ref,Val,Package,PosX,PosY,Rot,Side), which JLCPCB's
    importer doesn't recognize and rejects with no error message. Reformatted
    to their expected template: Designator,Mid X,Mid Y,Layer,Rotation
    (Layer values capitalized: Top/Bottom). Same 72 rows/positions, just
    relabeled.
2026-10-16 Fix R27/R24 schematic-PCB reference mismatch; expand BOM ranges
    Root cause of the BOM/CPL mismatch JLCPCB reported: a PCB footprint at
    (227.33, 127.49) was still labeled "R27" (value 10k, pad1 on +5V -- a
    pull-up resistor) while the schematic calls the same part "R24". A full
    schematic-vs-PCB reference diff confirmed this was the only mismatch
    (likely a leftover from a schematic rename during the user's own
    optimization pass that never got pushed to the PCB via "Update PCB from
    Schematic"). Renamed the PCB footprint's Reference property to match the
    schematic. pcb drc: still 0 violations, 0 unconnected.
    Also regenerated bom.csv/bom_smd_assembly.csv with
    --ref-range-delimiter "" so designato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
2026-10-16 Regenerate Gerbers/drill after R27->R24 silkscreen refdes fix
    The previous Gerber set was plotted before the R27->R24 rename, so
    F_Silkscreen still showed the old "R27" text. Regenerated all layers +
    drill files + zip from the current board so silkscreen matches the BOM.
2026-10-16 Add JLCPCB/MFR part numbers to SMD assembly BOM, merge 100nF/0.1uF
    User sourced exact LCSC stock + manufacturer part numbers for all 10
    unique SMD line items by checking JLCPCB's catalog directly (resolving
    the part-match/shortfall errors from their first BOM upload attempt).
    Added as two proper CSV columns (LCSC Part#, MFR.Part#) -- the first
    hand-edit attempt had these crammed space-separated into the Designator
    field instead of real columns, fixed here.
    Also merged the two capacitor groups that were really the same part
    (100nF and 0.1uF are the same value, just written differently by two
    different schematic-generator scripts) into one line, LCSC C2991729 /
    0603B104J250NT, qty 21. D1 (1N5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
2026-10-16 Split mixed-prefix 10k resistor BOM line (R1-24 vs R_SW1-6)
    JLCPCB's uploader blocked the order on this line ("multiple types of
    parts, but one type has been matched") despite the 30 designators being
    verified identical (same footprint R_0603_1608Metric, same value 10k,
    checked directly against the PCB file). Likely cause: the line mixed two
    designator naming styles (plain R# vs R_SW#), which JLCPCB's parser
    probably pattern-matches on and treats as a type mismatch. Split into
    two lines, same LCSC/MFR part (C5139509 / ABD03K1002FT), grouped by
    naming style instead. BOM designator set still matches cpl_smd.csv
    exactly (72/72).
2026-10-16 Document JLCPCB PCBA submission lessons learned (order placed)
    New design_notes.md §11, with a strong flagged note on the one that'll
    bite hardest next time: every IC (SN74LVC8T245 x8, MAX3232 x1, both
    Package_SO footprints) needed a manual +90 degree rotation correction in
    JLCPCB's web assembly preview -- KiCad's CPL rotation for SOIC/TSSOP
    doesn't match JLCPCB's placement convention, a known mismatch on their
    side that can't be fixed from the exported CPL file, only caught by eye
    in their preview before confirming. Also documents the other upload
    issues worked through this session: CPL column header naming, BOM
    designator range expansion, the mixed-designator-naming-style rejection,
    and t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
